chandak1299/Application-Form-Reader/README.md

# Application-Form-Reader

This project was made by a team of 4 students - 
1. Siddharth Chandak
2. Harsh Dolhare
3. Abhishek Tanpure
4. Jatin Lamba

[Video of working of the project](https://www.youtube.com/watch?v=CcTt0Aj-cIU)

[Presentation](https://docs.google.com/presentation/d/17WbmU1E8Q4_Bl1QHxI4QihCQX7nwdo8q2Sv_l45VG6A/edit?usp=sharing)
