chandak1299/Application-Form-Reader/Application_Form.pdf

# APPLICATION FORM

NAME-

FATHER’S NAME-

MOBILE No.-

AADHAAR No.- Parent Mob.
